sparkfunX/RGB-OLED-Breakout-64x64-0.6/Documents/ConnectorDrawing_10051922.pdf

PDM: Rev:H | Released | . STATUS: | Printed: Jun 24, 2010
