sparkfunX/RGB-OLED-Breakout-64x64-0.6/Hardware/Board_Design_Checklist_RGB_OLED_64x64_0.6_Breakout_X01.xls

SECTION | CHECK | STATUS | DEPENDANCY | CORRECT ANSWER | USER | USER-ANSWER | COMMENT | WIKI_LINK
Macro | is_revision | 0
Macro | has_pth | 0
Macro | has_i2c | 0
Macro | has_SPI | 1
Macro | has_1x6_ftdi_header | 0
Macro | has_jumpers | 0
Macro | has_leds | 0
Macro | has_vreg | 1
Macro | has_QFN | 0
Macro | has_SS | 0
Macro | has_multi_sheet | 0
Macro | is_kit | 0
Macro | has_serial | 0
Macro | is_4layer | 0
Macro | has_milling | 0
Macro | has_switchorbutton | 0
Macro | has_collaboration | 0
General | Are the part libraries consistent with eagle github repo? |  |  | YES | owen.lyke | YES
Schematic | Is the proper frame with CC attribution used? |  |  | YES | owen.lyke | YES
Schematic | Are all schematic objects inside the frame? |  |  | YES | owen.lyke | YES
Schematic | Is there a SparkFun Logo? |  |  | YES | owen.lyke | YES
Schematic | Is there an OSHW logo? |  |  | YES | owen.lyke | YES
Schematic | Is proper attribution given to the original designer? |  |  | YES | owen.lyke | YES
Schematic | Is "Revised by: " and the reviser's name present? |  | 2 | YES | owen.lyke | *n/a*
Schematic | Are NET labels the correct FLAG type? |  |  | YES | owen.lyke | YES
Schematic | Have all nets been drawn straight out from pin connections at least one grid space? |  |  | YES | owen.lyke | YES
Schematic | Are all net lines 0.006 inch? |  |  | YES | owen.lyke | YES
Schematic | Are there any 4-way junctions? |  |  | NO | owen.lyke | NO
Schematic | Are junction dots used for all 3-wire connections? |  |  | YES | owen.lyke | YES
Schematic | Are the fiducials in the lower right corner? |  |  | YES | owen.lyke | YES
Schematic | Are the standoffs in the lower right corner? |  |  | YES | owen.lyke | YES
Schematic | Are dashed grey lines ('info' eagle layer 97) used to clearly separate different areas? |  |  | YES | owen.lyke | YES
Schematic | Is the version number correct? |  |  | YES | owen.lyke | YES
Schematic | Is the version number included on all sheets? |  | 12 | YES | owen.lyke | *n/a*
Schematic | Do all GND connections use the GND symbol (oriented downward)? |  |  | YES | owen.lyke | YES
Schematic | Do all VCC connections use the VCC symbol (oriented upward)? |  |  | YES | owen.lyke | YES
Schematic | Is the VCC range clearly labeled? |  |  | YES | owen.lyke | YES
Schematic | Are any jumpers labeled clearly by their function and possible settings? |  | 7 | YES | owen.lyke | *n/a*
Schematic | Are any appropriate warnings (voltage conversion, sensitive I/O) labeled? |  |  | YES | owen.lyke | n/a
Schematic | Are any notes of two versions of the board in the schematic (3.3V regulator vs 5V regulator)? |  |  | YES | owen.lyke | n/a
Schematic | Do any part names have '/.~' in them? (Multiple sheets) |  | 12 | NO | owen.lyke | *n/a*
Schematic | Have you verified that the BOM in Sparkle is accurate (also checking for PROD_ID, NAME, VALUE, PREFIX)? |  |  | YES | owen.lyke | n/a
Schematic | Do any parts have unnecessary values (Eagle has autoset the package as the value)? |  |  | NO | owen.lyke | NO
Schematic | Regarding the voltage regulator, is the input on the LEFT, and the output on the RIGHT? |  | 9 | YES | owen.lyke | YES
Schematic | Is the I2C address in the schematic? |  | 4 | YES | owen.lyke | *n/a*
Schematic | Is the I2C pin order correct (GND/VCC/SDA/CLK) and did you consider using a Qwiic connector? |  | 4 | YES | owen.lyke | *n/a* |  | https://wiki.sparkfun.com/index.php?title=Eagle_Rules#Pin_Out.2FConnection_Orientation
Schematic | Is the I2C pull-up resistor isolation jumper present? |  | 4 | YES | owen.lyke | *n/a* |  | https://wiki.sparkfun.com/index.php?title=Eagle_Rules#Component_Placement
Schematic | Is the SPI pull-up resistor for Chip Select present? |  | 5 | YES | owen.lyke | YES |  | https://wiki.sparkfun.com/index.php?title=Eagle_Rules#Component_Placement
Schematic | Is the MISO tri-state buffer included? |  | 5 | YES | owen.lyke | NO | No MISO line | https://wiki.sparkfun.com/index.php?title=Eagle_Rules#Component_Placement
Board | If this is a Qwiic board, does it follow the design guidelines for Qwiic boards in the Wiki? |  | 4 | YES | owen.lyke | *n/a* |  | https://wiki.sparkfun.com/index.php?title=Qwiic_Standard
Board | If this board is not branded as a Qwicc board, but contains a Qwiic connector, is the connector labeled with “QWIIC” text silk? |  | 4 |  | owen.lyke | n/a
Board | Are the inner layers on the correct eagle layers? (2 and 15) |  | 15 | YES | owen.lyke | *n/a* |  | https://wiki.sparkfun.com/index.php?title=Eagle_Rules#Board_Creation.2C_Outline
Board | Does your 4 layer board include '1' '2' '3' '4' in the copper of each layer? |  | 15 | YES | owen.lyke | *n/a* |  | https://wiki.sparkfun.com/index.php?title=Eagle_Rules#Board_Creation.2C_Outline
Board | Is the bottom left corner board dimensions at 0,0? |  |  | YES | owen.lyke | YES |  | https://wiki.sparkfun.com/index.php?title=Eagle_Rules#Board_Creation.2C_Outline
Board | Is the board dimension outline correct thickness? (0.008 inch) |  |  | YES | owen.lyke | YES |  | https://wiki.sparkfun.com/index.php?title=Eagle_Rules#Board_Creation.2C_Outline
Board | If this requires very precise dimensions (e.g. USB stick), did you consider GP's tolerances? (dimension=5mils, Vscore=10mils) |  |  |  | owen.lyke | n/a |  | https://wiki.sparkfun.com/index.php?title=Eagle_Rules#Fab_house_Tolerances
Board | Are 0.1 inch headers lined up on 0.1 inch grid? |  |  | YES | owen.lyke | NO | Only one set of headers, lined up on 0.1 in grid horiontally but only 50 mil from bottom of board vertically. | https://wiki.sparkfun.com/index.php?title=Eagle_Rules#Board_Creation.2C_Outline
Board | Are opposing 0.1 inch headers spaced to fit into a breadboard? |  |  | YES | owen.lyke | n/a |  | https://wiki.sparkfun.com/index.php?title=Eagle_Rules#Board_Creation.2C_Outline
Board | Do all testpoints have a separation of at least 0.1 inch (preferably placed on a 0.05 inch grid)? |  |  | YES | owen.lyke | n/a |  | https://wiki.sparkfun.com/index.php?title=Eagle_Rules#Board_Creation.2C_Outline
Board | Does the board have standoffs? |  |  | YES | owen.lyke | YES |  | https://wiki.sparkfun.com/index.php?title=Eagle_Rules#Board_Creation.2C_Outline
Board | Can standoffs/screws be used clear of other parts? |  |  | YES | owen.lyke | YES |  | https://wiki.sparkfun.com/index.php?title=Eagle_Rules#Board_Creation.2C_Outline
Board | Is the FTDI connector accessible (do neighboring parts allow enough space to clear each side)? |  | 6 | YES | owen.lyke | *n/a* |  | https://wiki.sparkfun.com/index.php?title=Eagle_Rules#Pin_Out.2FConnection_Orientation
Board | Is the FTDI connector oriented so the FTDI breakout can be slid on properly (IC side up, header side down)? |  | 6 | YES | owen.lyke | *n/a* |  | https://wiki.sparkfun.com/index.php?title=Eagle_Rules#Pin_Out.2FConnection_Orientation
Board | Are vias tented correctly? |  |  | YES | owen.lyke | YES |  | https://wiki.sparkfun.com/index.php?title=Eagle_Rules#Trace_Routing.2C_Polygon_Pours.2C_and_Vias
Board | If possible, are all overhanging parts on the same edge of the board (this helps with panelization)? |  |  | YES | owen.lyke | n/a |  | https://wiki.sparkfun.com/index.php?title=Eagle_Rules#Pin_Out.2FConnection_Orientation
Board | If this design requires special ordering or production assembly instructions, have the symbols/packages been added with notes? (PCB thickness, humidity sensitivity, etc.) |  |  | YES | owen.lyke | n/a
Board | Are any vias intended to be used as PTH headers (they shouldn't be)? |  |  | NO | owen.lyke | NO |  | https://wiki.sparkfun.com/index.php?title=Eagle_Rules#Trace_Routing.2C_Polygon_Pours.2C_and_Vias
Board | Is the LED color standard followed? (red for power, blue for STAT, green for TX, yellow for RX) |  | 8 | YES | owen.lyke | *n/a* |  | https://wiki.sparkfun.com/index.php?title=Eagle_Rules#Component_Placement
Board | Do parts that need selective solder have a planned nozzle path on layer 48? (valid widths: 0.178", 0,263", 0.354") |  | 11 | YES | owen.lyke | *n/a* |  | https://wiki.sparkfun.com/index.php?title=Eagle_Rules#Selective_Soldering
Board | As best as possible, do all SMD pads have only 1 trace entering the pad? |  |  | YES | owen.lyke | YES |  | https://wiki.sparkfun.com/index.php?title=Eagle_Rules#PCB_Layout
Board | Are there any natural bridges on SMT components? |  |  | NO | owen.lyke | NO |  | https://wiki.sparkfun.com/index.php?title=Eagle_Rules#PCB_Layout
Board | Do V-Scored edges have a 50 mil border free of pads and parts (to prevent cracking on separation)? |  |  | YES | owen.lyke | n/a
Board | Is the direction of TX/RX serial connections correct? |  | 14 | YES | owen.lyke | *n/a*
Board | Are the TX/RX pins of the FTDI properly connected? |  | 6 | YES | owen.lyke | *n/a*
Board | Is trace routing up to spec? (to/from center-points, straight lines, 45 angles, 'T' intersections, no right angles or acid traps) |  |  | YES | owen.lyke | YES |  | https://wiki.sparkfun.com/index.php?title=Eagle_Rules#PCB_Layout
Board | For thermal considerations, are traces routed away from the component, with symmetrical routing? |  | 10 | YES | owen.lyke | *n/a*
Board | Do all footprints pass 1:1 check? (Applies mostly to new components) |  |  | YES | owen.lyke | n/a
Board | Are all QFN components with 6 or more leads 75 percent pasted on lead pads? (May be contended depending on performance) |  | 10 | YES | owen.lyke | *n/a* |  | https://wiki.sparkfun.com/index.php?title=Eagle_Rules#Footprints.2FPackages
Board | Are center pad cream apertures properly reduced? (50-75% paste is good) |  | 10 | YES | owen.lyke | *n/a* |  | https://wiki.sparkfun.com/index.php?title=Eagle_Rules#Footprints.2FPackages
Board | Is there solder mask between pads on of 11 mil separation and greater? |  |  | YES | owen.lyke | YES |  | https://wiki.sparkfun.com/index.php?title=Eagle_Rules#Fab_house_Tolerances
Board | Is there a correct version number in the copper (aligned properly with the edge of the PCB)? |  |  | YES | owen.lyke | YES
Board | Are there fiducials on both the TOP and BOTTOM of the board? |  |  | YES | owen.lyke | YES
Board | Does it pass DRC with top/bottom keepout layers on? |  |  | YES | owen.lyke | NO | Keepout errors from closely spaced resistors at top left approved by myself according to the wiki
Board | If there are any DRC errors, have they all been approved? |  |  | YES | owen.lyke | YES
Board | Are there airwires after ratsnest? |  |  | NO | owen.lyke | NO
Board | Are all KIT PTH parts on the correct side with correct masking (e.g. the TSTOP or BSTOP expose the correct side) |  | 13 | YES | owen.lyke | *n/a*
Documentation | Is there a note for a 4-layer board (on tDOCU)? |  | 15 | YES | owen.lyke | *n/a*
Documentation | Do all packages have NAME and VALUE? |  |  | YES | owen.lyke | YES
Documentation | Is there a note for a board thickness other than 0.63 inch? |  |  |  | owen.lyke | n/a
Documentation | Are measurements included for outer dimension and standoffs (Eagle layer 47)? |  |  | YES | owen.lyke | YES
Documentation | Are the board dimensions on 0.05 inch or 0.01 inch grid? |  |  | YES | owen.lyke | YES
Documentation | Are routed-out areas labeled 'ROUTE OUT' (on dimension)? |  | 16 | YES | owen.lyke | *n/a*
Documentation | Is the CC/Design By included in tDocu? |  |  | YES | owen.lyke | YES
Documentation | Is the designer name included in tDocu? |  |  | YES | owen.lyke | YES
Documentation | Is 'Revised by:' and 'Revisor Name' included in tDocu? |  | 2 | YES | owen.lyke | *n/a*
Silkscreen/Labeling | Is the name of the board on the board? |  |  | YES | owen.lyke | YES |  | https://wiki.sparkfun.com/index.php?title=Eagle_Rules#PCB_Silk
Silkscreen/Labeling | Do all footprints have 0.008 inch silk footprint? |  |  | YES | owen.lyke | YES
Silkscreen/Labeling | Are all LEDs labeled with their purpose? |  | 8 | YES | owen.lyke | *n/a*
Silkscreen/Labeling | Are all PTHs (aka connectors) clearly labeled with their purpose on both sides of the board? |  |  | YES | owen.lyke | YES
Silkscreen/Labeling | Are battery terminals labeled +/- correctly? |  |  | YES | owen.lyke | YES
Silkscreen/Labeling | Are all jumpers labeled? |  | 7 | YES | owen.lyke | *n/a*
Silkscreen/Labeling | If it is a 3-way jumper, is there a label on each side of the jumper? |  | 7 | YES | owen.lyke | *n/a*
Silkscreen/Labeling | Are all switches/buttons labeled properly? |  | 17 | YES | owen.lyke | *n/a*
Silkscreen/Labeling | Are active low pins labeled clearly? |  |  | YES | owen.lyke | YES
Silkscreen/Labeling | Are all labels lined up properly? |  |  | YES | owen.lyke | YES
Silkscreen/Labeling | Is all text at least 0.032 inch, 15 percent radio, and vector? |  |  | YES | owen.lyke | YES
Silkscreen/Labeling | Does the FTDI connector have BLK/GRN labeled correctly? |  | 6 | YES | owen.lyke | *n/a*
Silkscreen/Labeling | Do all components have polarity or pin 1 labeled? |  |  | YES | owen.lyke | YES
Silkscreen/Labeling | Is the polarity label outside of the package for visibility after part population? |  |  | YES | owen.lyke | YES
Silkscreen/Labeling | Are there check labels for different versions of the board (3.3V vs 5V)? |  |  | YES | owen.lyke | n/a
Silkscreen/Labeling | Is the SparkFun Logo on the board? |  |  | YES | owen.lyke | YES
Silkscreen/Labeling | Is the OSHW logo on the board? |  |  | YES | owen.lyke | YES
Silkscreen/Labeling | Is the firmware opensource? If not, did you omit the OSHW Logo? |  | 18 | YES | owen.lyke | *n/a*
Silkscreen/Labeling | Is any silkscreen overlaid on vias? |  |  | NO | owen.lyke | YES
Silkscreen/Labeling | Is there a URL for any kits or unique boards? |  |  |  | owen.lyke | n/a
Special | Are dimension lines properly spaced for V-scoring (lines on a 0.020” center-to-center spacing)? |  |  |  | owen.lyke | n/a
Special | On white solder mask pcbs, is there any solder mask between leads on large SMT components? |  |  |  | owen.lyke | n/a
Special | Are axes labeled correctly? |  |  |  | owen.lyke | n/a
Special | Are there warning labels for high voltage areas? |  |  |  | owen.lyke | NO | Is 12V "high voltage?" No warnings fro 12V boosted supply to OLED. Its all contained on the board without any external hookup areas
END | Thanks for flying with us. Have a great day!!
