sparkfunX/RGB-OLED-Breakout-64x64-0.6/Hardware/RGB_OLED_64x64_Schematic.pdf

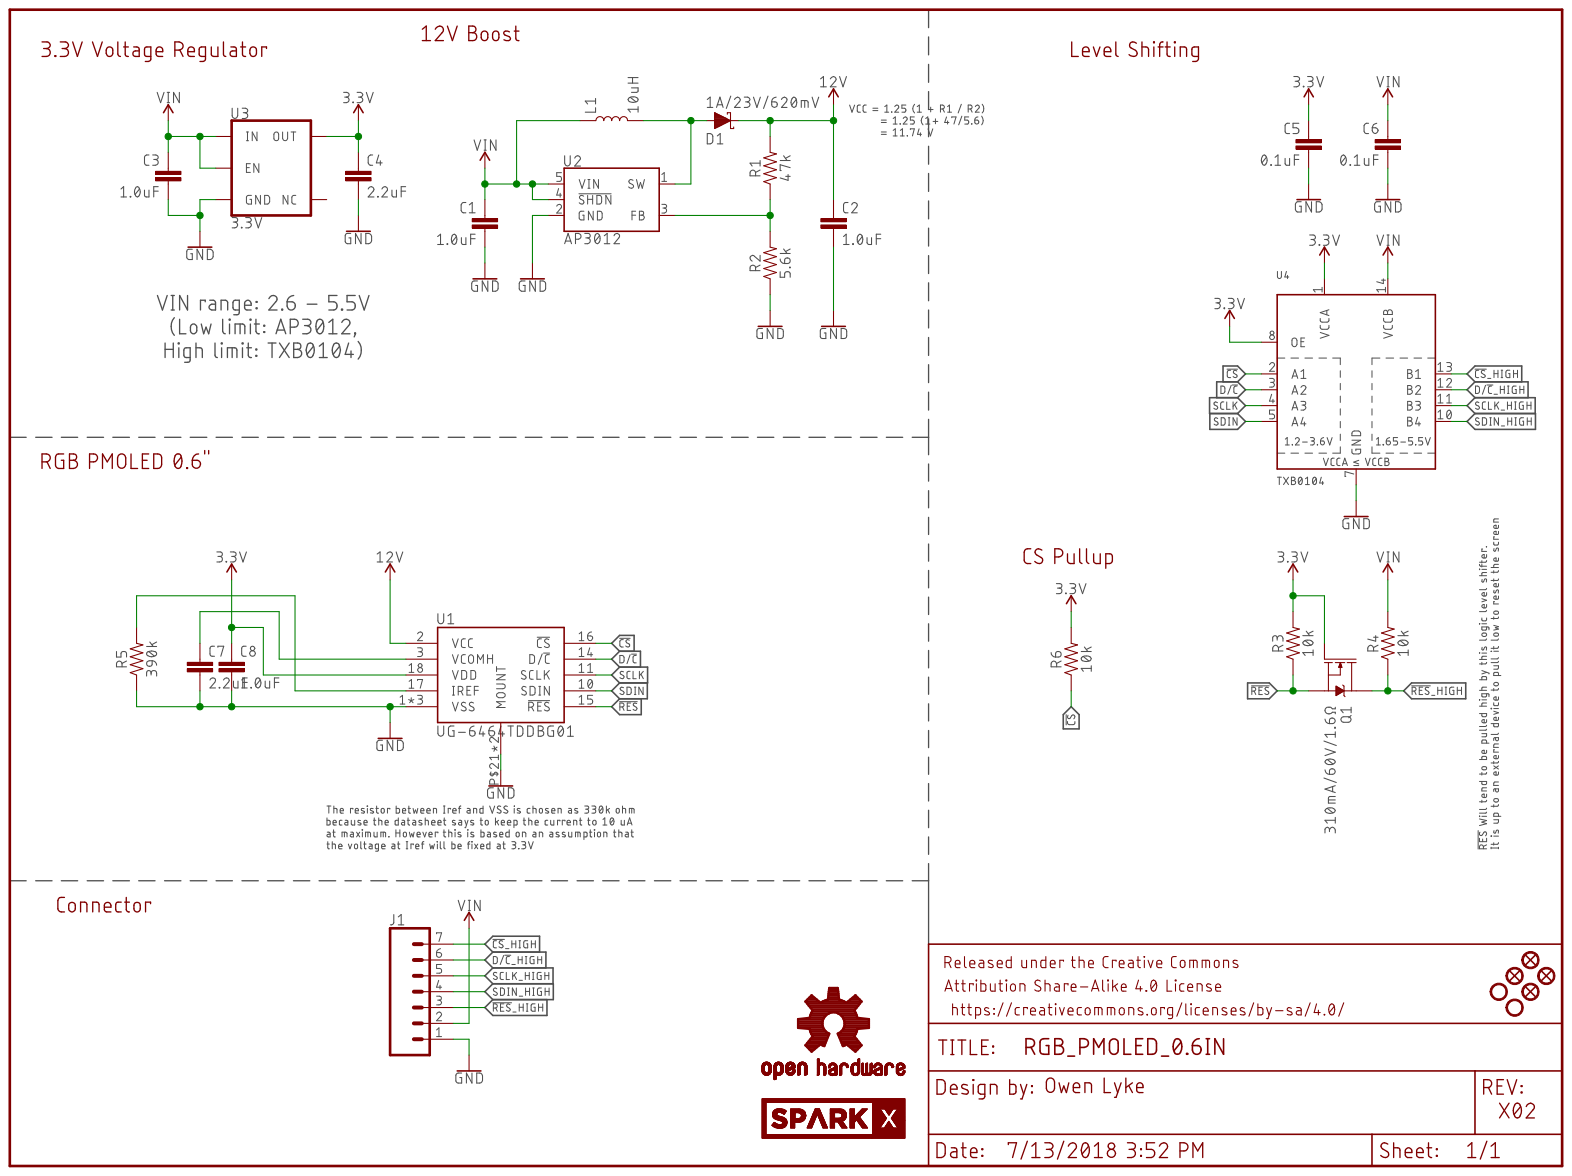
[picture p1: page 1]
