sparkfunX/RGB-OLED-Breakout-64x64-0.6/Hardware/RGB_PMOLED_0.6IN.brd

## EAGLE design Hardware/RGB_PMOLED_0.6IN.brd (2018-07-18)

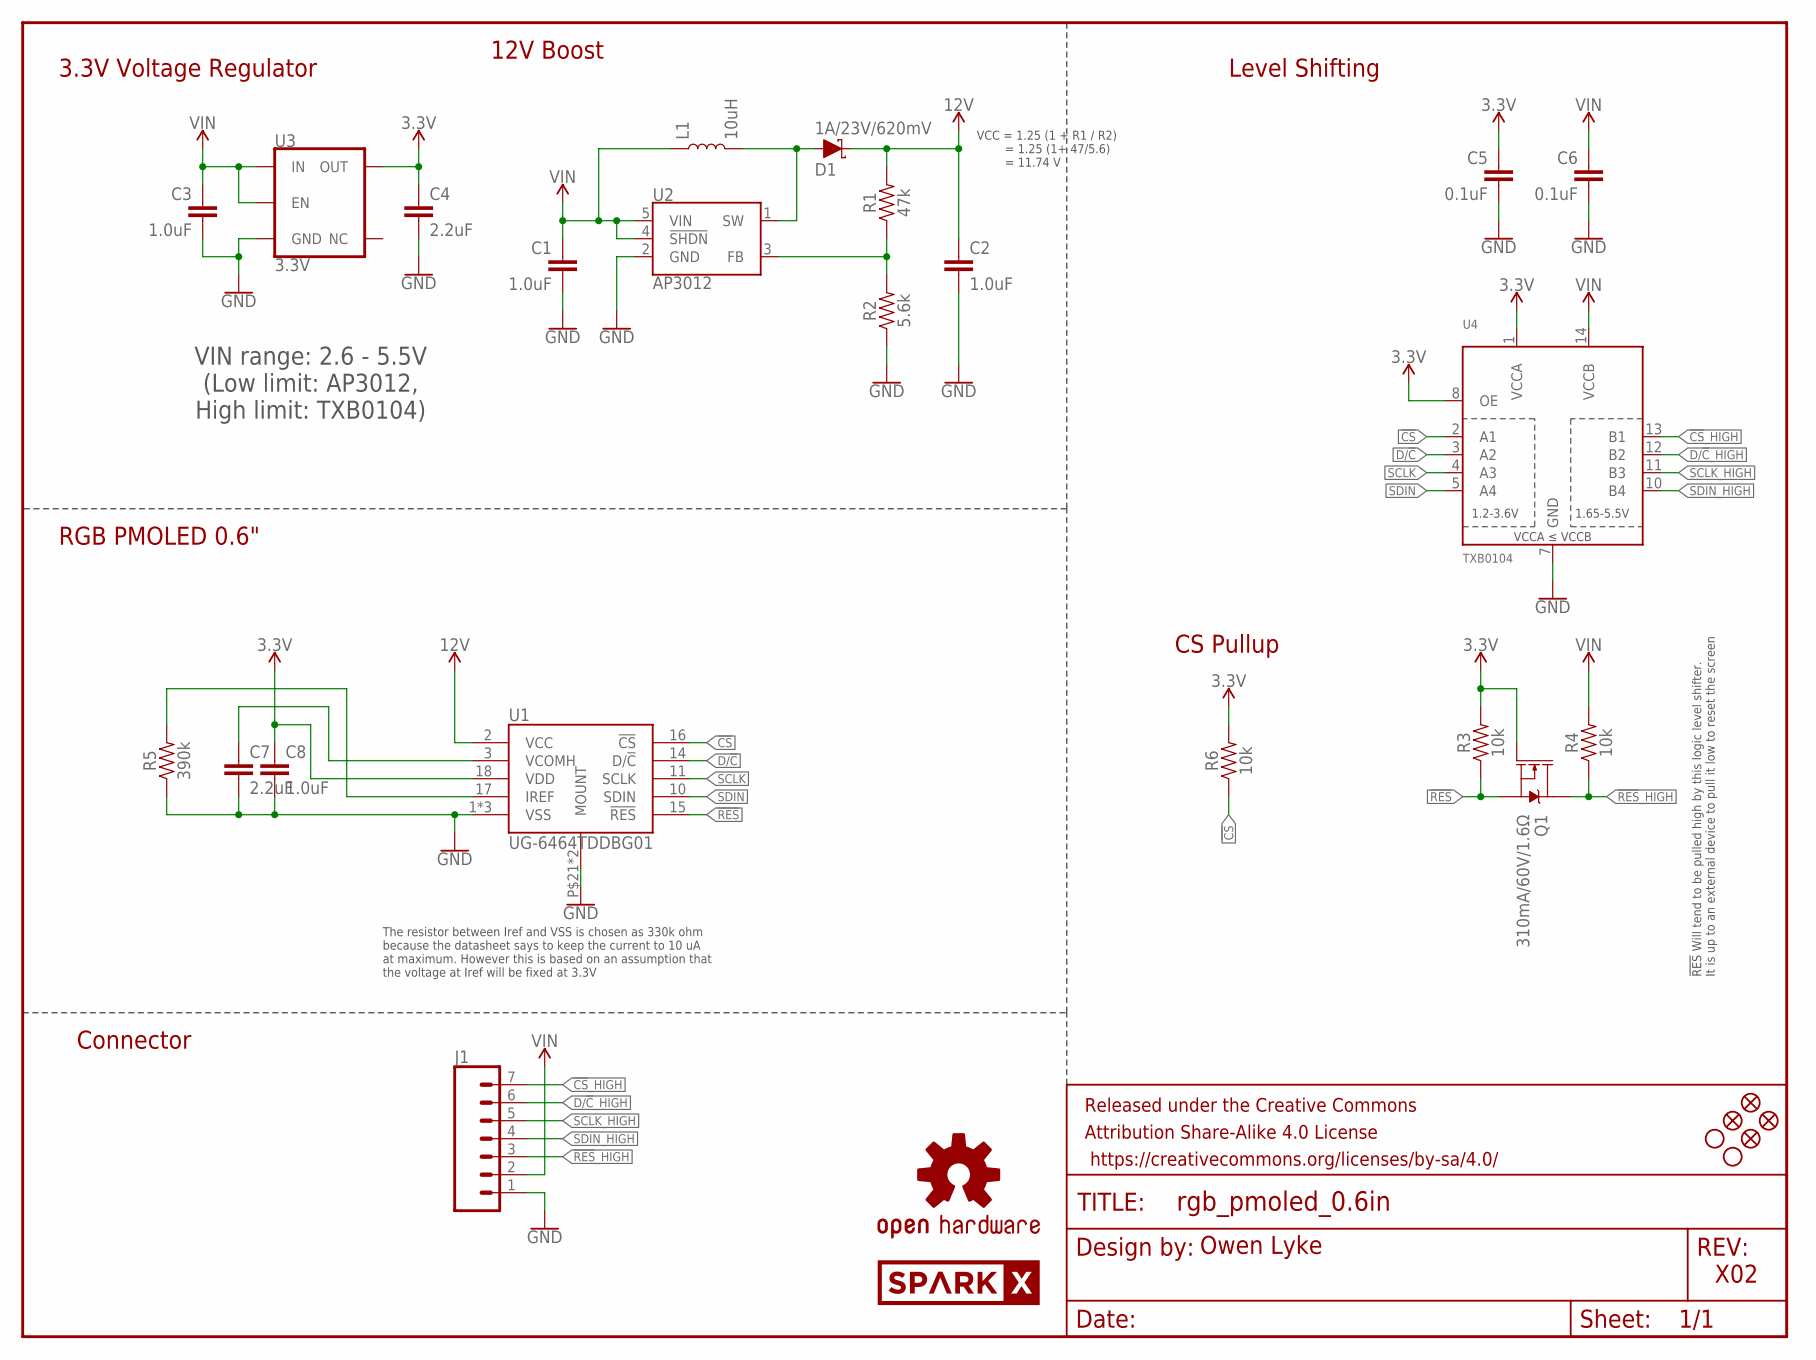
[picture p2: schematic RGB_PMOLED_0.6IN.sch]

Parts:
C1, C2, C3, C8: 1.0uF; 0603
C4: 2.2uF; 0603
C5, C6: 0.1uF; 0603
C7: 2.2uF; 0805
D1: 1A/23V/620mV; SOD-323
FD1, FD2, FD3, FD4: FIDUCIAL1X2; FIDUCIAL-1X2
FRAME1: FRAME-LETTER; CREATIVE_COMMONS
H1, H2: STAND-OFF
J1: CONN_07NO_SILK; 1X07_NO_SILK
L1: 10uH; INDUCTOR_4.7UH
LOGO1: SPARKX-LOGO5; SPARKX-LARGE
LOGO2: OSHW-LOGOS; OSHW-LOGO-S
Q1: 310mA/60V/1.6Ω; SOT323
R1: 47k; 0603
R2: 5.6k; 0603
R3, R4, R6: 10k; 0603
R5: 390k; 0603
U1: UG-6464TDDBG01; AMPHENOL_10051922-2010ELF
U2: AP3012; SOT23-5
U3: 3.3V; SOT23-5
U4: TXB0104; SO14

Connections:
3.3V: C4.1, C5.1, C8.1, Q1.1 (G), R3.2, R6.2, U1.18 (VDD), U3.5 (OUT), U4.1 (VCCA), U4.8 (OE)
12V: C2.1, D1.C, R1.2, U1.2 (VCC)
!CS: R6.1, U1.16 (!CS), U4.2 (A1)
!CS!_HIGH: J1.7, U4.13 (B1)
!RES: Q1.2 (S), R3.1, U1.15 (!RES)
!RES!_HIGH: J1.3, Q1.3 (D), R4.1
D/!C: U1.14 (D/!C), U4.3 (A2)
D/!C!_HIGH: J1.6, U4.12 (B2)
GND: C1.2, C2.2, C3.2, C4.2, C5.2, C6.2, C7.2, C8.2, J1.1, R2.1, R5.1, U1.1 (VSS), U1.19 (VSS), U1.20 (VSS), U1.P$21 (MOUNT), U1.P$22 (MOUNT), U2.2 (GND), U3.2 (GND), U4.7 (GND)
unnamed: D1.A, L1.P$2 (2), U2.1 (SW)
unnamed: R1.1, R2.2, U2.3 (FB)
unnamed: C7.1, U1.3 (VCOMH)
unnamed: R5.2, U1.17 (IREF)
SCLK: U1.11 (SCLK), U4.4 (A3)
SCLK_HIGH: J1.5, U4.11 (B3)
SDIN: U1.10 (SDIN), U4.5 (A4)
SDIN_HIGH: J1.4, U4.10 (B4)
VIN: C1.1, C3.1, C6.1, J1.2, L1.P$1 (1), R4.2, U2.4 (!SHDN!), U2.5 (VIN), U3.1 (IN), U3.3 (EN), U4.14 (VCCB)

Notes on the sheet:
VCC = 1.25 (1 + R1 / R2) = 1.25 (1+ 47/5.6) = 11.74 V
12V Boost
VIN range: 2.6 - 5.5V (Low limit: AP3012, High limit: TXB0104)
3.3V Voltage Regulator
Level Shifting
Owen Lyke
!RES! Will tend to be pulled high by this logic level shifter. It is up to an external device to pull it low to reset the screen
The resistor between Iref and VSS is chosen as 330k ohm because the datasheet says to keep the current to 10 uA at maximum. However this is based on an assumption that the voltage at Iref will be fixed at 3.3V
RGB PMOLED 0.6"
Connector
X02
CS Pullup

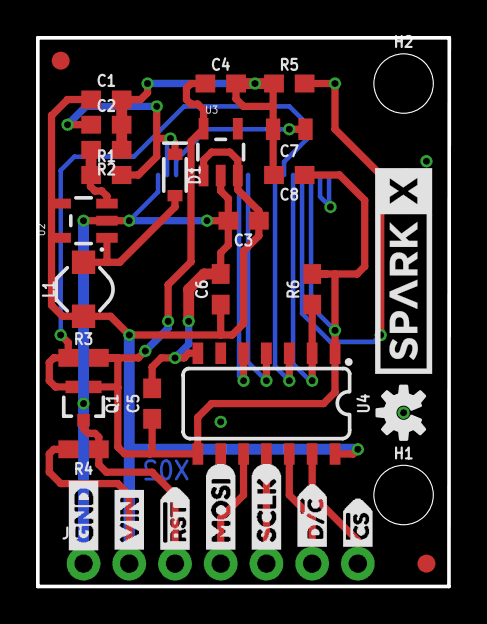
[picture p3: board RGB_PMOLED_0.6IN.brd from above]

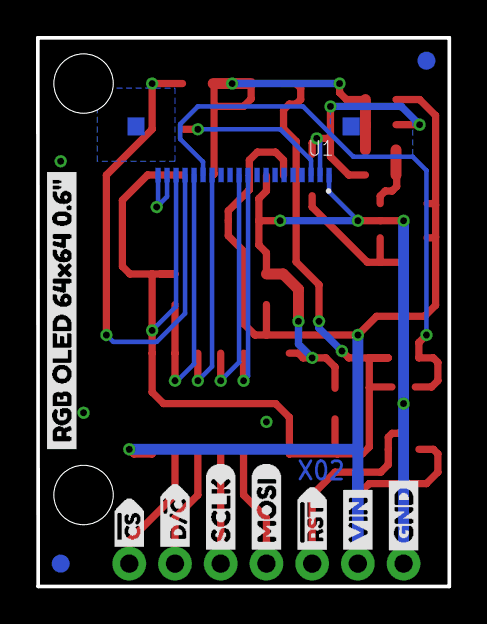
[picture p4: board RGB_PMOLED_0.6IN.brd from below]

Board: 2 copper layers, 22.9 x 30.5 mm, 46 parts (11 on the bottom side), 18 nets.

Other parts of the board:
U$1, U$2: VIN0
U$3, U$4: MOSI1
U$5, U$6: SCLK2
U$7, U$8: GND1
U$9, U$14: D##C5
U$10, U$11: #RST0
U$12, U$13: #CS6
U$16: RGB_OLED_64X64_0#6#7
