sparkfunX/RGB-OLED-Breakout-64x64-0.6/Hardware/Production/RGB_PMOLED_0.6IN-Panel.brd

## EAGLE design Hardware/Production/RGB_PMOLED_0.6IN-Panel.brd (2018-07-18)

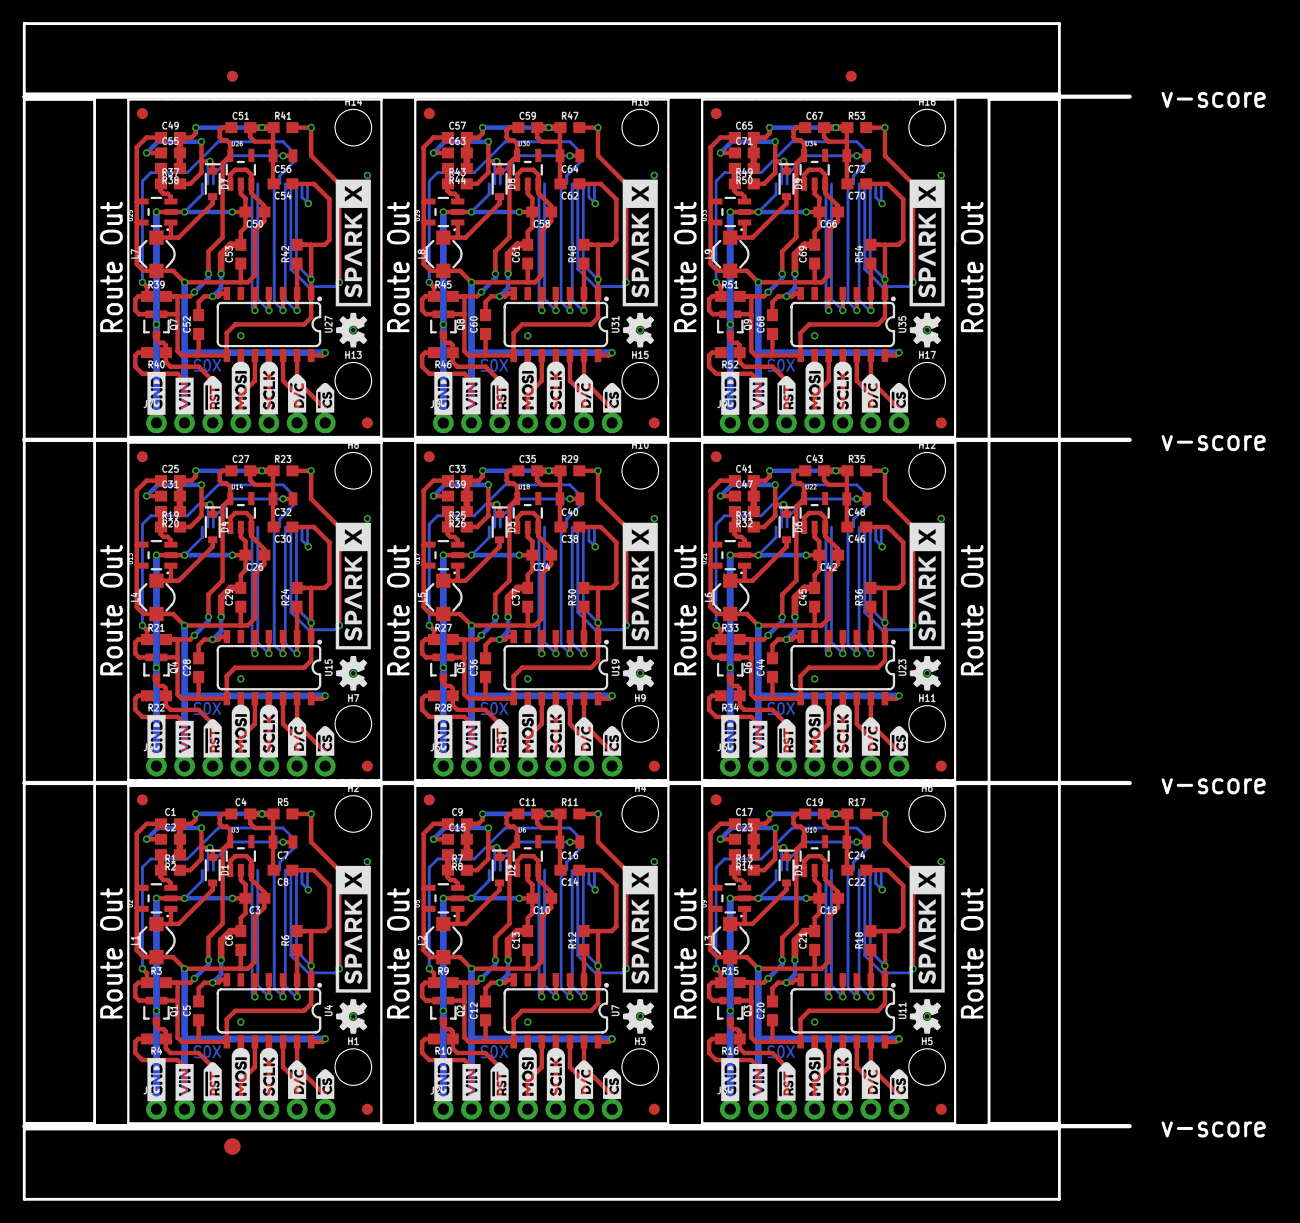
[picture p5: board RGB_PMOLED_0.6IN-Panel.brd from above]

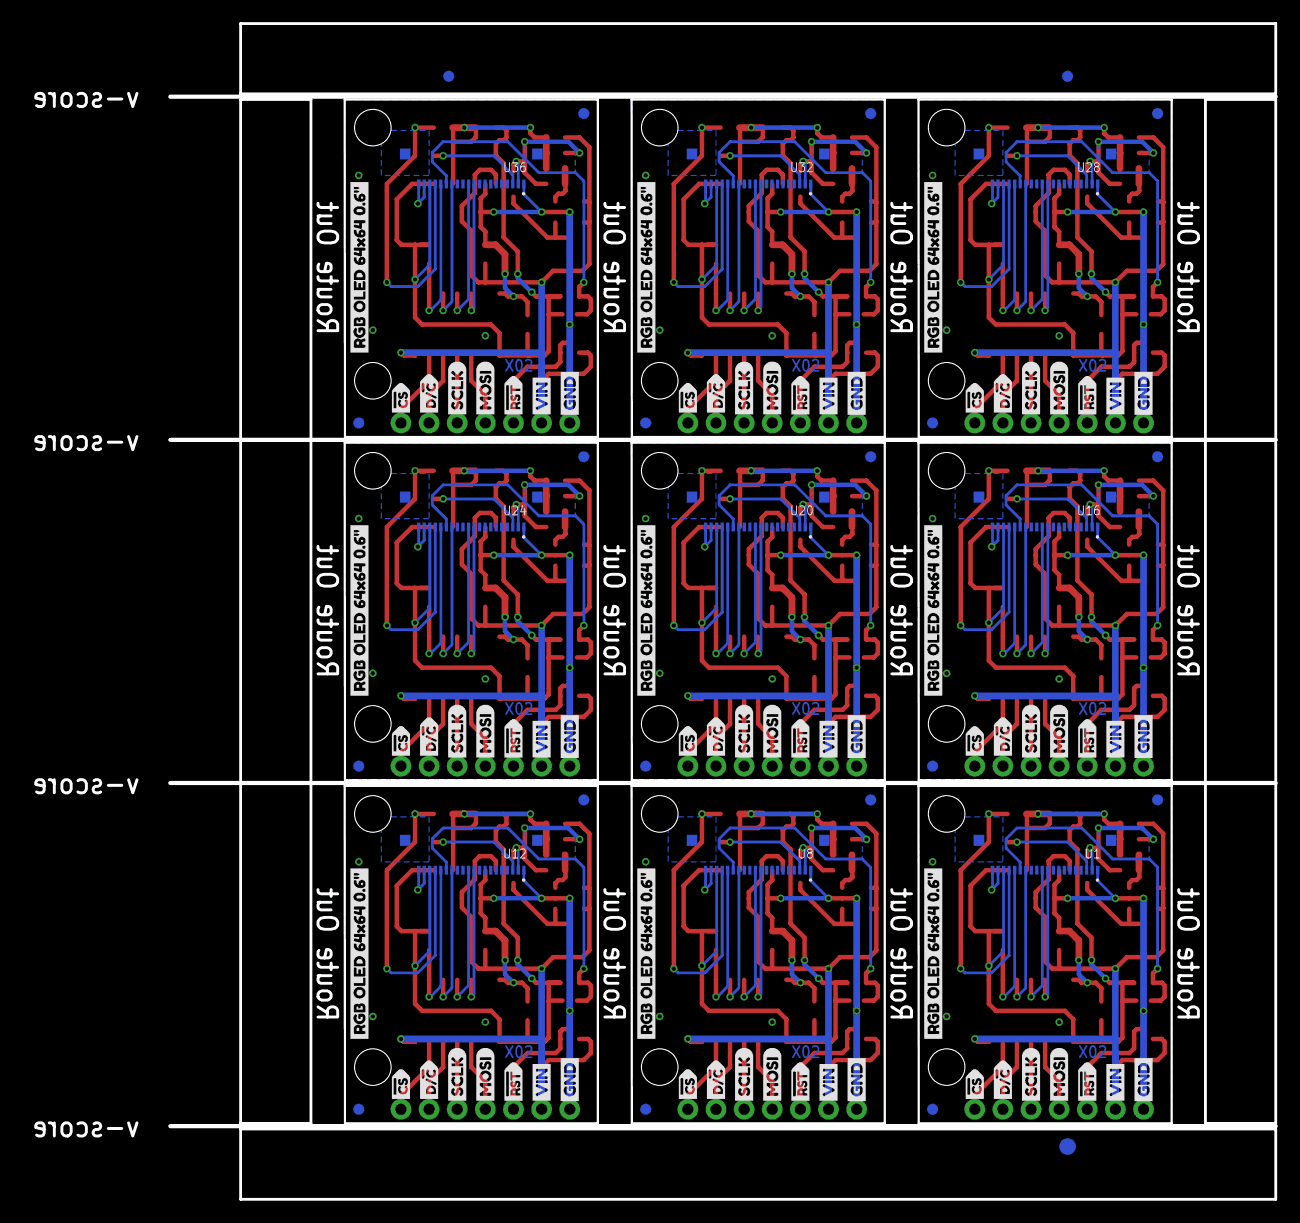
[picture p6: board RGB_PMOLED_0.6IN-Panel.brd from below]

Board: 2 copper layers, 99.8 x 106.2 mm, 411 parts (102 on the bottom side), 162 nets.

Parts:
C1, C2, C3, C8, C9, C10, C14, C15, C17, C18, C22, C23, C25, C26, C30, C31, C33, C34, C38, C39, C41, C42, C46, C47, C49, C50, C54, C55, C57, C58, C62, C63, C65, C66, C70, C71: 1.0uF; 0603
C4, C11, C19, C27, C35, C43, C51, C59, C67: 2.2uF; 0603
C5, C6, C12, C13, C20, C21, C28, C29, C36, C37, C44, C45, C52, C53, C60, C61, C68, C69: 0.1uF; 0603
C7, C16, C24, C32, C40, C48, C56, C64, C72: 2.2uF; 0805
D1, D2, D3, D4, D5, D6, D7, D8, D9: 1A/23V/620mV; SOD-323
E$1, E$2, E$3, E$4: FIDUCIAL-1X2
E$5, E$6: FIDUCIAL-1.5X3
FD1, FD2, FD3, FD4, FD5, FD6, FD7, FD8, FD9, FD10, FD11, FD12, FD13, FD14, FD15, FD16, FD17, FD18, FD19, FD20, FD21, FD22, FD23, FD24, FD25, FD26, FD27, FD28, FD29, FD30, FD31, FD32, FD33, FD34, FD35, FD36: FIDUCIAL1X2; FIDUCIAL-1X2
H1, H2, H3, H4, H5, H6, H7, H8, H9, H10, H11, H12, H13, H14, H15, H16, H17, H18: STAND-OFF
J1, J2, J3, J4, J5, J6, J7, J8, J9: 1X07_NO_SILK
L1, L2, L3, L4, L5, L6, L7, L8, L9: 10uH; INDUCTOR_4.7UH
LOGO1, LOGO3, LOGO5, LOGO7, LOGO9, LOGO11, LOGO13, LOGO15, LOGO17: SPARKX-LOGO5; SPARKX-LARGE
LOGO2, LOGO4, LOGO6, LOGO8, LOGO10, LOGO12, LOGO14, LOGO16, LOGO18: OSHW-LOGOS; OSHW-LOGO-S
Q1, Q2, Q3, Q4, Q5, Q6, Q7, Q8, Q9: 310mA/60V/1.6Ω; SOT323
R1, R7, R13, R19, R25, R31, R37, R43, R49: 47k; 0603
R2, R8, R14, R20, R26, R32, R38, R44, R50: 5.6k; 0603
R3, R4, R6, R9, R10, R12, R15, R16, R18, R21, R22, R24, R27, R28, R30, R33, R34, R36, R39, R40, R42, R45, R46, R48, R51, R52, R54: 10k; 0603
R5, R11, R17, R23, R29, R35, R41, R47, R53: 390k; 0603
U1, U8, U12, U16, U20, U24, U28, U32, U36: UG-6464TDDBG01; AMPHENOL_10051922-2010ELF
U2, U5, U9, U13, U17, U21, U25, U29, U33: AP3012; SOT23-5
U3, U6, U10, U14, U18, U22, U26, U30, U34: 3.3V; SOT23-5
U4, U7, U11, U15, U19, U23, U27, U31, U35: TXB0104; SO14
U$1, U$2, U$15, U$17, U$31, U$32, U$46, U$47, U$61, U$62, U$76, U$77, U$91, U$92, U$106, U$107, U$121, U$122: VIN0
U$3, U$4, U$27, U$28, U$42, U$43, U$57, U$58, U$72, U$73, U$87, U$88, U$102, U$103, U$117, U$118, U$132, U$133: MOSI1
U$5, U$6, U$29, U$30, U$44, U$45, U$59, U$60, U$74, U$75, U$89, U$90, U$104, U$105, U$119, U$120, U$134, U$135: SCLK2
U$7, U$8, U$18, U$19, U$33, U$34, U$48, U$49, U$63, U$64, U$78, U$79, U$93, U$94, U$108, U$109, U$123, U$124: GND1
U$9, U$14, U$22, U$23, U$37, U$38, U$52, U$53, U$67, U$68, U$82, U$83, U$97, U$98, U$112, U$113, U$127, U$128: D##C5
U$10, U$11, U$25, U$26, U$40, U$41, U$55, U$56, U$70, U$71, U$85, U$86, U$100, U$101, U$115, U$116, U$130, U$131: #RST0
U$12, U$13, U$20, U$21, U$35, U$36, U$50, U$51, U$65, U$66, U$80, U$81, U$95, U$96, U$110, U$111, U$125, U$126: #CS6
U$16, U$24, U$39, U$54, U$69, U$84, U$99, U$114, U$129: RGB_OLED_64X64_0#6#7

Connections:
3.3V: C4.1, C5.1, C8.1, Q1.1, R3.2, R6.2, U1.18, U3.5, U4.1, U4.8
3.3V1: C11.1, C12.1, C14.1, Q2.1, R9.2, R12.2, U6.5, U7.1, U7.8, U8.18
3.3V2: C19.1, C20.1, C22.1, Q3.1, R15.2, R18.2, U10.5, U11.1, U11.8, U12.18
3.3V3: C27.1, C28.1, C30.1, Q4.1, R21.2, R24.2, U14.5, U15.1, U15.8, U16.18
3.3V4: C35.1, C36.1, C38.1, Q5.1, R27.2, R30.2, U18.5, U19.1, U19.8, U20.18
3.3V5: C43.1, C44.1, C46.1, Q6.1, R33.2, R36.2, U22.5, U23.1, U23.8, U24.18
3.3V6: C51.1, C52.1, C54.1, Q7.1, R39.2, R42.2, U26.5, U27.1, U27.8, U28.18
3.3V7: C59.1, C60.1, C62.1, Q8.1, R45.2, R48.2, U30.5, U31.1, U31.8, U32.18
3.3V8: C67.1, C68.1, C70.1, Q9.1, R51.2, R54.2, U34.5, U35.1, U35.8, U36.18
12V: C2.1, D1.C, R1.2, U1.2
12V1: C15.1, D2.C, R7.2, U8.2
12V2: C23.1, D3.C, R13.2, U12.2
12V3: C31.1, D4.C, R19.2, U16.2
12V4: C39.1, D5.C, R25.2, U20.2
12V5: C47.1, D6.C, R31.2, U24.2
12V6: C55.1, D7.C, R37.2, U28.2
12V7: C63.1, D8.C, R43.2, U32.2
12V8: C71.1, D9.C, R49.2, U36.2
!CS: R6.1, U1.16, U4.2
!CS1: R12.1, U7.2, U8.16
!CS2: R18.1, U11.2, U12.16
!CS3: R24.1, U15.2, U16.16
!CS4: R30.1, U19.2, U20.16
!CS5: R36.1, U23.2, U24.16
!CS6: R42.1, U27.2, U28.16
!CS7: R48.1, U31.2, U32.16
!CS8: R54.1, U35.2, U36.16
!CS!_HIGH: J1.7, U4.13
!CS!_HIGH1: J2.7, U7.13
!CS!_HIGH2: J3.7, U11.13
!CS!_HIGH3: J4.7, U15.13
!CS!_HIGH4: J5.7, U19.13
!CS!_HIGH5: J6.7, U23.13
!CS!_HIGH6: J7.7, U27.13
!CS!_HIGH7: J8.7, U31.13
!CS!_HIGH8: J9.7, U35.13
!RES: Q1.2, R3.1, U1.15
!RES1: Q2.2, R9.1, U8.15
!RES2: Q3.2, R15.1, U12.15
!RES3: Q4.2, R21.1, U16.15
!RES4: Q5.2, R27.1, U20.15
!RES5: Q6.2, R33.1, U24.15
!RES6: Q7.2, R39.1, U28.15
!RES7: Q8.2, R45.1, U32.15
!RES8: Q9.2, R51.1, U36.15
!RES!_HIGH: J1.3, Q1.3, R4.1
!RES!_HIGH1: J2.3, Q2.3, R10.1
!RES!_HIGH2: J3.3, Q3.3, R16.1
!RES!_HIGH3: J4.3, Q4.3, R22.1
!RES!_HIGH4: J5.3, Q5.3, R28.1
!RES!_HIGH5: J6.3, Q6.3, R34.1
!RES!_HIGH6: J7.3, Q7.3, R40.1
!RES!_HIGH7: J8.3, Q8.3, R46.1
!RES!_HIGH8: J9.3, Q9.3, R52.1
D/!C: U1.14, U4.3
D/!C1: U7.3, U8.14
D/!C2: U11.3, U12.14
D/!C3: U15.3, U16.14
D/!C4: U19.3, U20.14
D/!C5: U23.3, U24.14
D/!C6: U27.3, U28.14
D/!C7: U31.3, U32.14
D/!C8: U35.3, U36.14
D/!C!_HIGH: J1.6, U4.12
D/!C!_HIGH1: J2.6, U7.12
D/!C!_HIGH2: J3.6, U11.12
D/!C!_HIGH3: J4.6, U15.12
D/!C!_HIGH4: J5.6, U19.12
D/!C!_HIGH5: J6.6, U23.12
D/!C!_HIGH6: J7.6, U27.12
D/!C!_HIGH7: J8.6, U31.12
D/!C!_HIGH8: J9.6, U35.12
GND: C1.2, C2.2, C3.2, C4.2, C5.2, C6.2, C7.2, C8.2, J1.1, R2.1, R5.1, U1.1, U1.19, U1.20, U1.P$21, U1.P$22, U2.2, U3.2, U4.7
GND1: C9.2, C10.2, C11.2, C12.2, C13.2, C14.2, C15.2, C16.2, J2.1, R8.1, R11.1, U5.2, U6.2, U7.7, U8.1, U8.19, U8.20, U8.P$21, U8.P$22
GND2: C17.2, C18.2, C19.2, C20.2, C21.2, C22.2, C23.2, C24.2, J3.1, R14.1, R17.1, U9.2, U10.2, U11.7, U12.1, U12.19, U12.20, U12.P$21, U12.P$22
GND3: C25.2, C26.2, C27.2, C28.2, C29.2, C30.2, C31.2, C32.2, J4.1, R20.1, R23.1, U13.2, U14.2, U15.7, U16.1, U16.19, U16.20, U16.P$21, U16.P$22
GND4: C33.2, C34.2, C35.2, C36.2, C37.2, C38.2, C39.2, C40.2, J5.1, R26.1, R29.1, U17.2, U18.2, U19.7, U20.1, U20.19, U20.20, U20.P$21, U20.P$22
GND5: C41.2, C42.2, C43.2, C44.2, C45.2, C46.2, C47.2, C48.2, J6.1, R32.1, R35.1, U21.2, U22.2, U23.7, U24.1, U24.19, U24.20, U24.P$21, U24.P$22
GND6: C49.2, C50.2, C51.2, C52.2, C53.2, C54.2, C55.2, C56.2, J7.1, R38.1, R41.1, U25.2, U26.2, U27.7, U28.1, U28.19, U28.20, U28.P$21, U28.P$22
GND7: C57.2, C58.2, C59.2, C60.2, C61.2, C62.2, C63.2, C64.2, J8.1, R44.1, R47.1, U29.2, U30.2, U31.7, U32.1, U32.19, U32.20, U32.P$21, U32.P$22
GND8: C65.2, C66.2, C67.2, C68.2, C69.2, C70.2, C71.2, C72.2, J9.1, R50.1, R53.1, U33.2, U34.2, U35.7, U36.1, U36.19, U36.20, U36.P$21, U36.P$22
unnamed: D2.A, L2.P$2, U5.1
unnamed: D1.A, L1.P$2, U2.1
unnamed: R1.1, R2.2, U2.3
unnamed: R7.1, R8.2, U5.3
unnamed: C7.1, U1.3
unnamed: R11.2, U8.17
unnamed: C16.1, U8.3
unnamed: D3.A, L3.P$2, U9.1
unnamed: R13.1, R14.2, U9.3
unnamed: R17.2, U12.17
unnamed: R5.2, U1.17
unnamed: C24.1, U12.3
unnamed: D4.A, L4.P$2, U13.1
unnamed: R19.1, R20.2, U13.3
unnamed: R23.2, U16.17
unnamed: C32.1, U16.3
unnamed: D5.A, L5.P$2, U17.1
unnamed: R25.1, R26.2, U17.3
unnamed: R29.2, U20.17
unnamed: C40.1, U20.3
unnamed: D6.A, L6.P$2, U21.1
unnamed: R31.1, R32.2, U21.3
unnamed: R35.2, U24.17
unnamed: C48.1, U24.3
unnamed: D7.A, L7.P$2, U25.1
unnamed: R37.1, R38.2, U25.3
unnamed: R41.2, U28.17
unnamed: C56.1, U28.3
unnamed: D8.A, L8.P$2, U29.1
unnamed: R43.1, R44.2, U29.3
unnamed: R47.2, U32.17
unnamed: C64.1, U32.3
unnamed: D9.A, L9.P$2, U33.1
unnamed: R49.1, R50.2, U33.3
unnamed: R53.2, U36.17
unnamed: C72.1, U36.3
SCLK: U1.11, U4.4
SCLK1: U7.4, U8.11
SCLK2: U11.4, U12.11
SCLK3: U15.4, U16.11
SCLK4: U19.4, U20.11
SCLK5: U23.4, U24.11
SCLK6: U27.4, U28.11
SCLK7: U31.4, U32.11
SCLK8: U35.4, U36.11
SCLK_HIGH: J1.5, U4.11
SCLK_HIGH1: J2.5, U7.11
SCLK_HIGH2: J3.5, U11.11
SCLK_HIGH3: J4.5, U15.11
SCLK_HIGH4: J5.5, U19.11
SCLK_HIGH5: J6.5, U23.11
SCLK_HIGH6: J7.5, U27.11
SCLK_HIGH7: J8.5, U31.11
SCLK_HIGH8: J9.5, U35.11
SDIN: U1.10, U4.5
SDIN1: U7.5, U8.10
SDIN2: U11.5, U12.10
SDIN3: U15.5, U16.10
SDIN4: U19.5, U20.10
SDIN5: U23.5, U24.10
SDIN6: U27.5, U28.10
SDIN7: U31.5, U32.10
SDIN8: U35.5, U36.10
SDIN_HIGH: J1.4, U4.10
SDIN_HIGH1: J2.4, U7.10
SDIN_HIGH2: J3.4, U11.10
SDIN_HIGH3: J4.4, U15.10
SDIN_HIGH4: J5.4, U19.10
SDIN_HIGH5: J6.4, U23.10
SDIN_HIGH6: J7.4, U27.10
SDIN_HIGH7: J8.4, U31.10
SDIN_HIGH8: J9.4, U35.10
VIN: C1.1, C3.1, C6.1, J1.2, L1.P$1, R4.2, U2.4, U2.5, U3.1, U3.3, U4.14
VIN1: C9.1, C10.1, C13.1, J2.2, L2.P$1, R10.2, U5.4, U5.5, U6.1, U6.3, U7.14
VIN2: C17.1, C18.1, C21.1, J3.2, L3.P$1, R16.2, U9.4, U9.5, U10.1, U10.3, U11.14
VIN3: C25.1, C26.1, C29.1, J4.2, L4.P$1, R22.2, U13.4, U13.5, U14.1, U14.3, U15.14
VIN4: C33.1, C34.1, C37.1, J5.2, L5.P$1, R28.2, U17.4, U17.5, U18.1, U18.3, U19.14
VIN5: C41.1, C42.1, C45.1, J6.2, L6.P$1, R34.2, U21.4, U21.5, U22.1, U22.3, U23.14
VIN6: C49.1, C50.1, C53.1, J7.2, L7.P$1, R40.2, U25.4, U25.5, U26.1, U26.3, U27.14
VIN7: C57.1, C58.1, C61.1, J8.2, L8.P$1, R46.2, U29.4, U29.5, U30.1, U30.3, U31.14
VIN8: C65.1, C66.1, C69.1, J9.2, L9.P$1, R52.2, U33.4, U33.5, U34.1, U34.3, U35.14
