sparkfunX/RGB-OLED-Breakout-64x64-0.6/Hardware/Production/ordering_instructions.txt

panel size, 94x107mm
PCB thickness, 1.6mm
number of layers, 2
soldermask color, Black
silkscreen color, White
oz copper, 1oz
finish, HASL lead free
stencils, top+bottom
pcs per panel, 9
