sparkfunX/RGB-OLED-Breakout-64x64-0.6/(commit log)

2018-06-12 Intemediate commit
    [RGB_PMOLED_0.6IN.brd, RGB_PMOLED_0.6IN.sch]
2018-06-12 First revision
    [RGB_PMOLED_0.6IN.brd, RGB_PMOLED_0.6IN.sch]
2018-06-13 Panelized and gerberified
    [Board_Design_Checklist_RGB_OLED_64x64_0.6_Breakout_X01.xls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]
2018-07-13 Revision 2 of board using a connector
    [RGB_PMOLED_0.6IN.brd, RGB_PMOLED_0.6IN.sch]
2018-07-13 Fixed clearance of 4-40 screw
    [RGB_PMOLED_0.6IN.brd]
2018-07-18 Cleaned up documentation
    [RGB_PMOLED_0.6IN-Panel.GBL, RGB_PMOLED_0.6IN-Panel.GBO, RGB_PMOLED_0.6IN-Panel.GBP, RGB_PMOLED_0.6IN-Panel.GBS, RGB_PMOLED_0.6IN-Panel.GKO, RGB_PMOLED_0.6IN-Panel.GTL, RGB_PMOLED_0.6IN-Panel.GTO, RGB_PMOLED_0.6IN-Panel.GTP]
